regisgo62/RouteurAC/README.md

# RouteurAC
<b> carte AC-DC </b> <br>
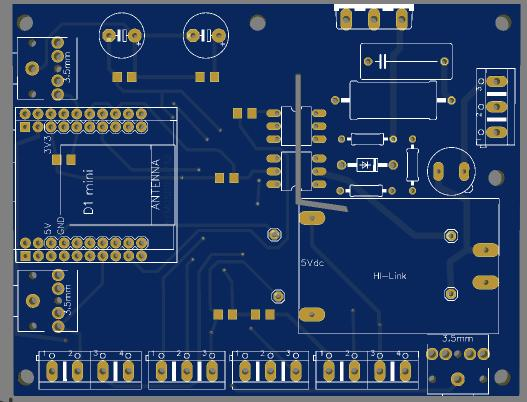
[picture p1: Hardware/img1.jpg]
