regisgo62/RouteurAC/Hardware/routeurre3.FCStd

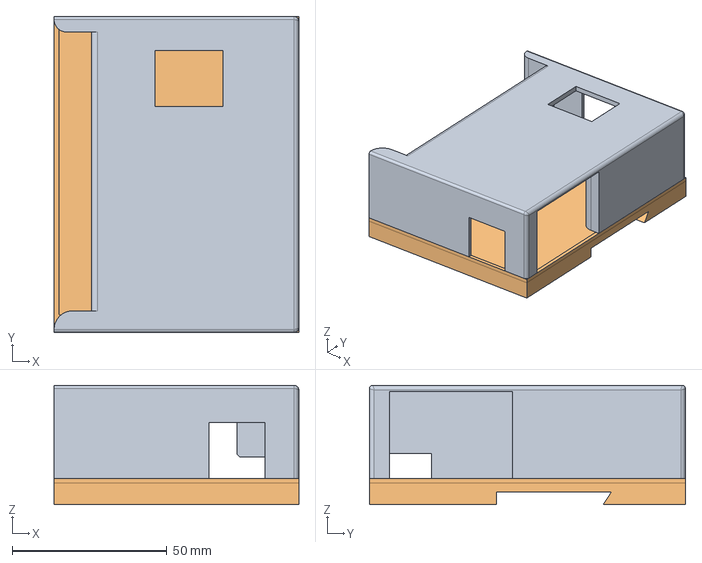
[picture p2: CAD file, 2020-07-16]
Hardware/routeurre3.FCStd
79.0 x 102.0 x 38.5 mm
Pocket001Body
