regisgo62/RouteurAC/Hardware/routeur3a.brd

## EAGLE design Hardware/routeur3a.brd (2020-07-16)

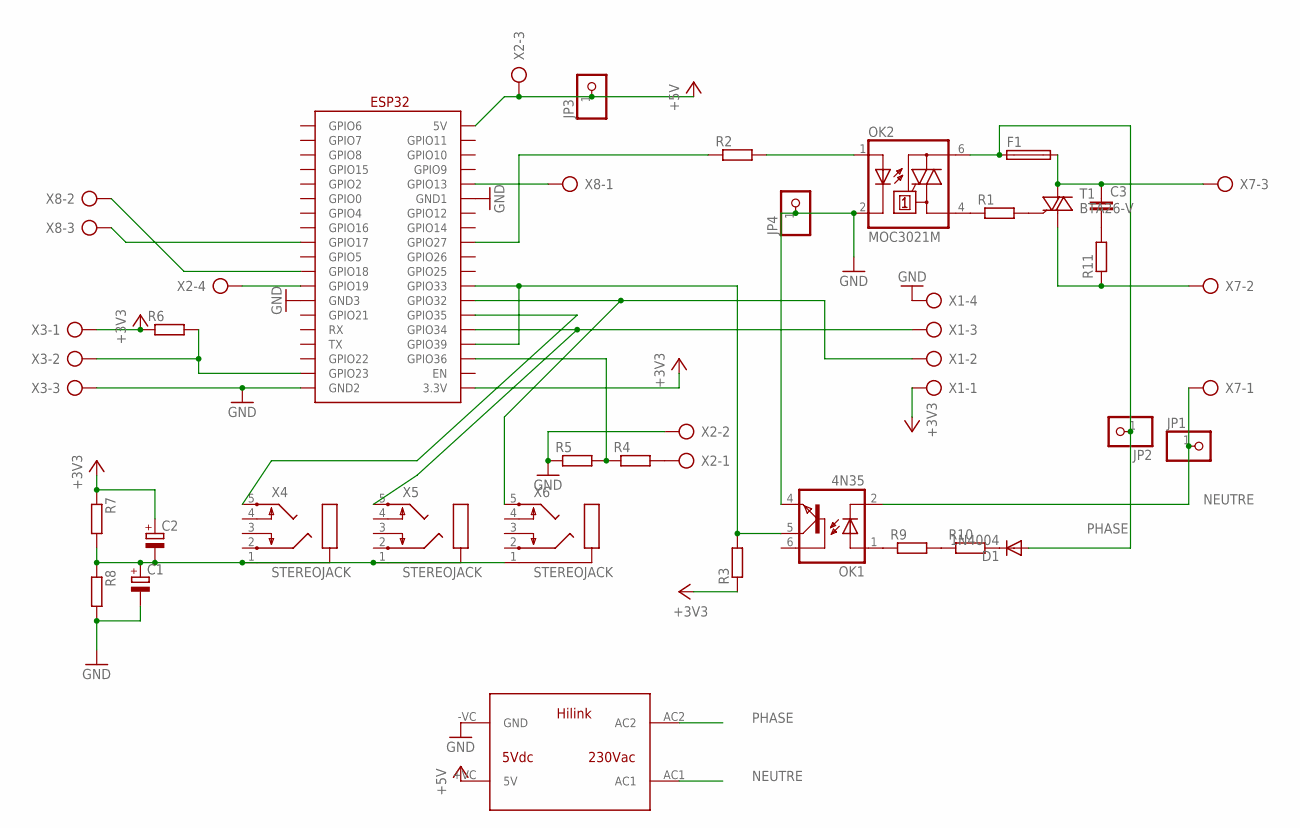
[picture p3: schematic routeur3a.sch]

Parts:
C1, C2: CPOL-EUE5-8.5; E5-8,5
C3: C-EU150-072X183; C150-072X183
D1: 1N4004; DO41-10
F1: 19560
JP1, JP2, JP3, JP4: PINHD-1X1; 1X01
OK1: 4N35; DIL06
OK2: MOC3021M; DIL06
R1, R9, R10: R-EU_0207/10; 0207/10
R2, R3, R4, R5, R6, R7, R8: R-EU_R1206; R1206
R11: R-EU_0817/22; P0817/22
T1: BTA26-V; TOP3S-1
U$1: WEMOSD1ESP32; WEMOS-D1-MINI
U$2: HILINK
X1, X2: AK500/4
X3, X7, X8: AK500/3
X4, X5, X6: STEREOJACK; STX3100

Connections:
+3V3: C2.+, R3.1, R6.1, R7.1, U$1.3V3 (3.3V), X1.1, X3.1
+5V: JP3.1, U$1.VCC (5V), U$2.+VC (5V), X2.3
GND: C1.-, JP4.1, OK1.4 (EMI), OK2.2 (C), R5.1, R8.2, U$1.GND (GND1), U$1.GND2, U$1.GND3, U$2.-VC (GND), X1.4, X2.2, X3.3
unnamed: OK2.4 (A1), R1.1
unnamed: OK2.1 (A), R2.2
unnamed: R4.2, X2.1
unnamed: R1.2, T1.G
unnamed: C3.1, F1.2, T1.A2, X7.3
unnamed: R11.1, T1.A1, X7.2
unnamed: OK1.1 (A), R9.1
unnamed: R9.2, R10.1
unnamed: U$1.TCK (GPIO13), X8.1
unnamed: D1.C, R10.2
unnamed: C1.+, C2.-, R7.2, R8.1, X4.1, X5.1, X6.1
unnamed: C3.2, R11.2
unnamed: U$1.35 (GPIO35), X4.5
NEUTRE: JP1.1, OK1.2 (C), U$2.AC1, X7.1
PHASE: D1.A, F1.1, JP2.1, OK2.6 (A2), U$2.AC2
PINCE: U$1.32 (GPIO32), X1.2, X6.5
PINCEREF: U$1.34 (GPIO34), X1.3, X5.5
PZEMRX: U$1.17 (GPIO17), X8.3
PZEMTX: U$1.18 (GPIO18), X8.2
RELAIS: U$1.19 (GPIO19), X2.4
TEMP: R6.2, U$1.23 (GPIO23), X3.2
TENSION: R4.1, R5.2, U$1.SVP (GPIO36)
TRIAC: R2.1, U$1.27 (GPIO27)
ZC: OK1.5 (COL), R3.2, U$1.33 (GPIO33), U$1.SUN (GPIO39)

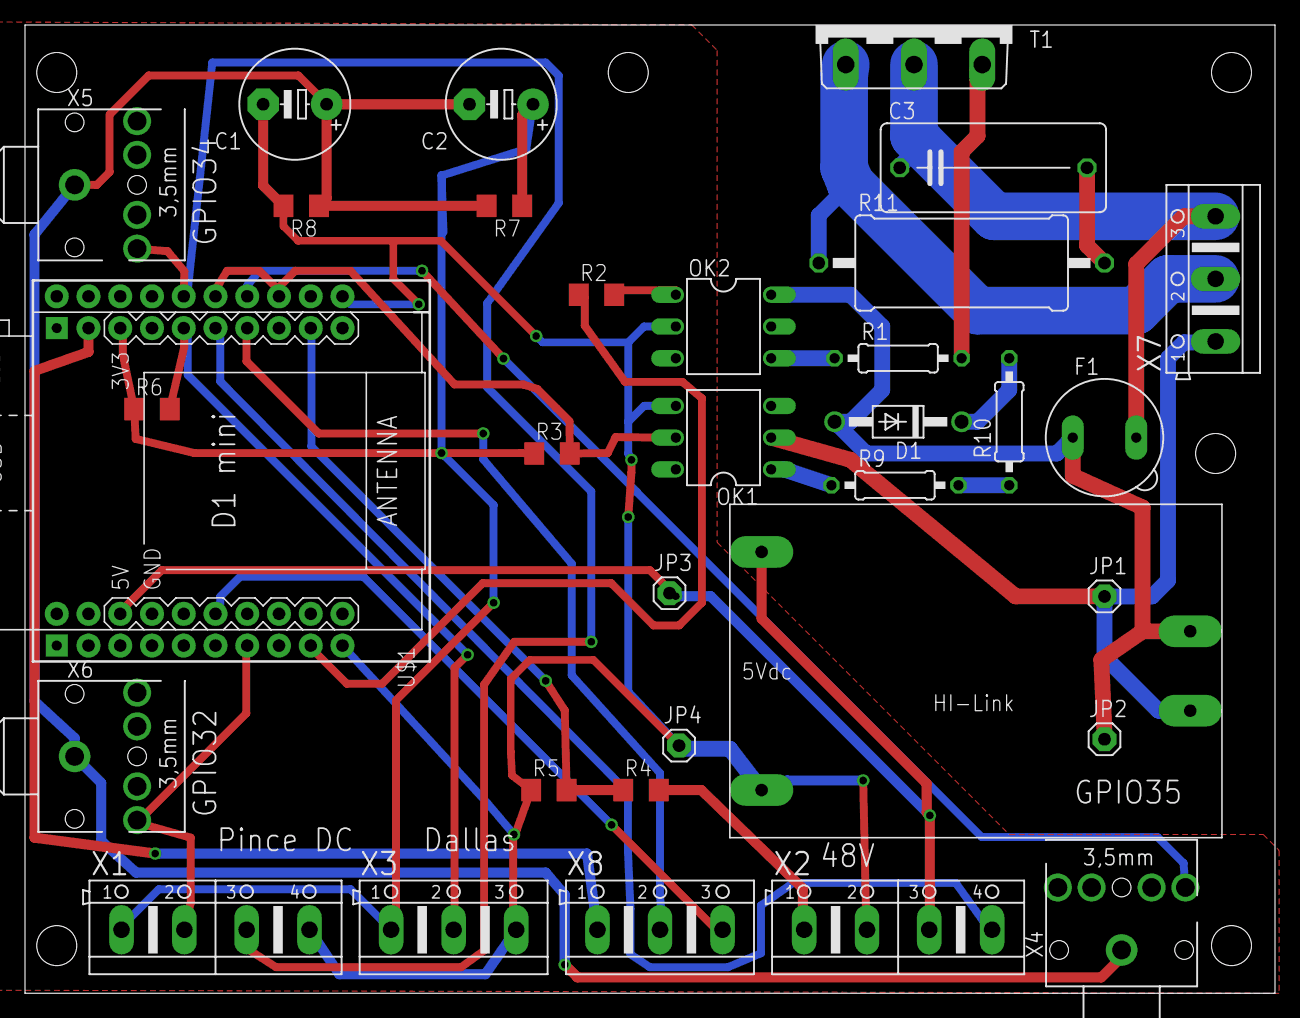
[picture p4: board routeur3a.brd from above]

Board: 2 copper layers, 100.0 x 77.5 mm, 33 parts (0 on the bottom side), 27 nets.
