regisgo62/RouteurAC/settings.h

#ifndef RA_SETTINGS_H
#define RA_SETTINGS_H
/**********************************************/
/********** Liste des options possibles ******/
/********************************************/
//#define parametrage // utiliser pour faire les essais sans les accessoires

//**** options MINI ****
#define EcranOled         // si pas d'écran oled      installer librairie heltec dev board
#define MesureTemperature // capteur DS18B20       installer librairie dallas temperature
#define WifiServer // affiche les mesures dans une page html crée un point d'accès si pas de reseau
//#define WifiMqtt   // mettre en commentaire si pas de réseau       installer librairie ArduinoJson et PubSubClient
//#define WifiSAPServeur // autorise le point d'accès si pas de reseau

//**** options MAXI  ****
#define F50HZ // Frequence du reseau 50Hz ou 60Hz non testé
//#define CourantAClimite 0.5  // Courant d'entrée alternatif pour arrêter le routeur si l'onduleur recharge les batteries sur le reseau
//#define relaisPWM   // convertit le gradateur en signal PWM sur la pin relais

struct param
{
  float   zeropince           = -0.0;           // valeur mesurer à zéro (2) 2819 2818.5
  float   coeffPince          = 1 ;         // Calculer le coefficient (4)0.14 0.210
  float   coeffTension        = 0.018293;       // diviseur de tension
  float seuilDemarrageBatterie = 56;                    // seuil de mise en marche de la regulation dans le ballon
  float toleranceNegative = 0.5;                        // autorisation de 300mA négative au moment de la charge complète
  bool utilisation2Sorties = false;                      // validation de la sortie 2eme gradateur
  float temperatureBasculementSortie2 = 60;             // température pour démarrer la regul sur la sortie 2
  float temperatureRetourSortie1 = 45;                  // température pour rebasculer sur le premier gradateur
  bool relaisStatique = false;                          // Indique si un relais statique est utilisé
  float seuilMarche = 50;                               // température ou tension de déclenchement du relais
  float seuilArret = 45;                                // température ou tension de déclenchement du relais
  char tensionOuTemperature[2] = "V";                   // Indique si le seuil est en Volts ou en Degrés
  char ssid[30] = "livebox_0";                      // ssid de la box internet
  char password[50] = "0"; // mot de passe
                                                          // en mode serveur l'ip est 192.168.4.1'
                                                          // ssid , "routeur_esp32"
                                                          // password , "adminesp32"
    char mqttServer[30] = "192.168.1.28";
    short int mqttPort = 1883;
    char mqttUser[30] = "";
    char mqttPassword[50] = "";
    char mqttopic[30] = "routeur/solar";
    char mqttopicInput[30] = "routeur/isolar";
    char mqttopicParam1[30] = "routeur/solar1";
    char mqttopicParam2[30] = "routeur/solar2";
    char mqttopicParam3[30] = "routeur/solar3";
    char mqttopicPzem1[30] = "routeur/Pzem1";
    float correctionTemperature = -2.3;
    char basculementMode[2] = "T"; // Choix du mode de basculement : T->température, P-> Puissance zero
};

extern struct param routeur; //  regroupe tous les parametres de configuration

extern bool marcheForcee; // validation de la sortie marche forcée
extern short int marcheForceePercentage;
extern unsigned long marcheForceeTemporisation; // temporisation de la marche forcée par défaut 1h

extern short int sortieActive;      // affichage triac actif par défaut le 1er
extern float intensiteDC;     // mesure de la pince à effet hall
extern float capteurTension;        // mesure de la tension batterie en volts
extern int puissanceGradateur;      // armorcage du triac
extern float temperatureEauChaude;  // mesure de la tension batterie en volts
extern float puissanceDeChauffe;    // mesure avec le pzem
extern float puissanceAC;           // mesure estimée avec la pince AC
extern float intensiteAC;           // mesure avec la pince AC
extern bool etatRelaisStatique;
extern int resetEsp;    // reset l'esp
extern int testwifi;    // perte de signal wifi ou mqtt
extern int choixSortie; // choix du triac1 ou 2
extern int paramchange; // si =1 alors l'envoie des parametres en mqtt
extern bool SAP;        // mode serveur initialisé en point d'acces
extern bool MQTT;       // verification du broker mqtt
extern bool serverOn;   // coupure du mqtt pendant le serveur
extern bool modeparametrage;
extern int devlente;
/***************************************/
/********** déclaration des Pins *******/
/***************************************/
extern const int pinTriac;
extern const int pinPince;
extern const int pinPinceACref;         
extern const int zeroc;
extern const int pinPinceRef;
extern const int pinPotentiometre;
extern const int pinTension;
extern const int pinTemp;
extern const int pinSortie2;
extern const int pinRelais;
extern bool wifiSAP;



#define RXD2 18 // Pin pour le Pzem v3.0 //18
#define TXD2 17 //17

#ifdef WifiSAPServeur
#define WifiServer
#endif

#ifdef WifiMqtt
#define WifiServer
#endif
#ifdef WifiServer
#define EEprom // sauvegarde des configurations dans eeprom passage de parametre par Wifi Mqtt
#endif
#ifdef Pzem04t
extern float Pzem_i;
extern float Pzem_U;
extern float Pzem_P;
extern float Pzem_W;
#endif

#endif
